EchoRaven/digital_logic/touch_board/touch_board.ip_user_files/README.txt

The files in this directory structure are automatically generated and managed by Vivado. Editing these files is not recommended.
