EchoRaven/digital_logic/touch_board/touch_board.runs/impl_1/.init_design.begin.rst

<?xml version="1.0"?>
<ProcessHandle Version="1" Minor="0">
    <Process Command=".planAhead." Owner="thb20" Host="THB" Pid="9660">
    </Process>
</ProcessHandle>
