EchoRaven/digital_logic/touch_board/touch_board.runs/blk_mem_gen_0_synth_1/.vivado.begin.rst

<?xml version="1.0"?>
<ProcessHandle Version="1" Minor="0">
    <Process Command="vivado.bat" Owner="thb20" Host="THB" Pid="5212">
    </Process>
</ProcessHandle>
