EchoRaven/digital_logic/touch_board/touch_board.runs/impl_1/usage_statistics_webtalk.html

### Device Usage Page (usage_statistics_webtalk.html)

This HTML page displays the device usage statistics that will be sent to Xilinx.
To see the actual file transmitted to Xilinx, please click here.

software_version_and_target_device
beta | FALSE | build_version | 1577090
date_generated | Fri Jan 06 22:36:52 2023 | os_platform | WIN64
product_version | Vivado v2016.2 (64-bit) | project_id | 5d2e6a21bd3f433cb3aeb27fb8cc0983
project_iteration | 230 | random_id | 56bf0cfc-a6ac-4a8f-aace-9724fa5de510
registration_id | 56bf0cfc-a6ac-4a8f-aace-9724fa5de510 | route_design | TRUE
target_device | xc7a100t | target_family | artix7
target_package | csg324 | target_speed | -1
tool_flow | Vivado

user_environment
cpu_name | 12th Gen Intel(R) Core(TM) i7-12700H | cpu_speed | 2688 MHz
os_name | Microsoft Windows 8 or later , 64-bit | os_release | major release (build 9200)
system_ram | 34.000 GB | total_processors | 1

vivado_usage

other_data

guimode=50

project_data
constraintsetcount=1 | core_container=false | currentimplrun=impl_1 | currentsynthesisrun=synth_1
default_library=xil_defaultlib | designmode=RTL | export_simulation_activehdl=5 | export_simulation_ies=5
export_simulation_modelsim=5 | export_simulation_questa=5 | export_simulation_riviera=5 | export_simulation_vcs=5
export_simulation_xsim=5 | implstrategy=Vivado Implementation Defaults | launch_simulation_activehdl=0 | launch_simulation_ies=0
launch_simulation_modelsim=0 | launch_simulation_questa=0 | launch_simulation_riviera=0 | launch_simulation_vcs=0
launch_simulation_xsim=5 | simulator_language=Mixed | srcsetcount=10 | synthesisstrategy=Vivado Synthesis Defaults
target_language=Verilog | target_simulator=XSim | totalimplruns=3 | totalsynthesisruns=3

unisim_transformation

post_unisim_transformation
bufg=4 | carry4=1099 | dsp48e1=37 | fdre=420
fdse=20 | gnd=229 | ibuf=15 | ldce=32
ldpe=3 | lut1=180 | lut2=2414 | lut3=933
lut4=410 | lut5=199 | lut6=288 | mmcme2_adv=1
muxf7=93 | muxf8=36 | obuf=25 | obuft=1
ramb18e1=2 | ramb36e1=103 | vcc=89

pre_unisim_transformation
bufg=4 | carry4=1099 | dsp48e1=37 | fdre=420
fdse=20 | gnd=229 | ibuf=16 | ldce=32
ldpe=3 | lut1=180 | lut2=2414 | lut3=933
lut4=410 | lut5=199 | lut6=288 | mmcme2_adv=1
muxf7=93 | muxf8=36 | obuf=25 | obuft=1
ramb18e1=2 | ramb36e1=103 | vcc=89

power_opt_design

command_line_options_spo
-cell_types=default::all | -clocks=default::[not_specified] | -exclude_cells=default::[not_specified] | -include_cells=default::[not_specified]

usage
bram_ports_augmented=117 | bram_ports_newly_gated=57 | bram_ports_total=210 | flow_state=default
slice_registers_augmented=0 | slice_registers_newly_gated=0 | slice_registers_total=440 | srls_augmented=0
srls_newly_gated=0 | srls_total=0

ip_statistics

blk_mem_gen_v8_3_3/1
c_addra_width=19 | c_addrb_width=19 | c_algorithm=1 | c_axi_id_width=4
c_axi_slave_type=0 | c_axi_type=1 | c_byte_size=9 | c_common_clk=0
c_count_18k_bram=1 | c_count_36k_bram=103 | c_ctrl_ecc_algo=NONE | c_default_data=0
c_disable_warn_bhv_coll=0 | c_disable_warn_bhv_range=0 | c_elaboration_dir=./ | c_en_deepsleep_pin=0
c_en_ecc_pipe=0 | c_en_rdaddra_chg=0 | c_en_rdaddrb_chg=0 | c_en_safety_ckt=0
c_en_shutdown_pin=0 | c_en_sleep_pin=0 | c_enable_32bit_address=0 | c_est_power_summary=Estimated Power for IP _ 16.887376 mW
c_family=artix7 | c_has_axi_id=0 | c_has_ena=1 | c_has_enb=1
c_has_injecterr=0 | c_has_mem_output_regs_a=0 | c_has_mem_output_regs_b=1 | c_has_mux_output_regs_a=0
c_has_mux_output_regs_b=0 | c_has_regcea=0 | c_has_regceb=0 | c_has_rsta=0
c_has_rstb=0 | c_has_softecc_input_regs_a=0 | c_has_softecc_output_regs_b=0 | c_init_file=blk_mem_gen_0.mem
c_init_file_name=no_coe_file_loaded | c_inita_val=0 | c_initb_val=0 | c_interface_type=0
c_load_init_file=0 | c_mem_type=1 | c_mux_pipeline_stages=0 | c_prim_type=1
c_read_depth_a=307200 | c_read_depth_b=307200 | c_read_width_a=12 | c_read_width_b=12
c_rst_priority_a=CE | c_rst_priority_b=CE | c_rstram_a=0 | c_rstram_b=0
c_sim_collision_check=ALL | c_use_bram_block=0 | c_use_byte_wea=0 | c_use_byte_web=0
c_use_default_data=0 | c_use_ecc=0 | c_use_softecc=0 | c_use_uram=0
c_wea_width=1 | c_web_width=1 | c_write_depth_a=307200 | c_write_depth_b=307200
c_write_mode_a=NO_CHANGE | c_write_mode_b=WRITE_FIRST | c_write_width_a=12 | c_write_width_b=12
c_xdevicefamily=artix7 | core_container=false | iptotal=1 | x_ipcorerevision=3
x_iplanguage=VERILOG | x_iplibrary=ip | x_ipname=blk_mem_gen | x_ipproduct=Vivado 2016.2
x_ipsimlanguage=MIXED | x_ipvendor=xilinx.com | x_ipversion=8.3

clk_wiz_v5_3_1/1
clkin1_period=10.0 | clkin2_period=10.0 | clock_mgr_type=NA | component_name=clk_wiz_0
core_container=false | enable_axi=0 | feedback_source=FDBK_AUTO | feedback_type=SINGLE
iptotal=1 | manual_override=false | num_out_clk=2 | primitive=MMCM
use_dyn_phase_shift=false | use_dyn_reconfig=false | use_inclk_stopped=false | use_inclk_switchover=false
use_locked=false | use_max_i_jitter=false | use_min_o_jitter=false | use_phase_alignment=true
use_power_down=false | use_reset=false

report_drc

command_line_options
-append=default::[not_specified] | -checks=default::[not_specified] | -fail_on=default::[not_specified] | -force=default::[not_specified]
-format=default::[not_specified] | -messages=default::[not_specified] | -name=default::[not_specified] | -return_string=default::[not_specified]

-ruledecks=default::[not_specified]

results
cfgbvs-1=1 | dpip-1=28 | dpop-1=34 | dpop-2=35
pdrc-153=6 | plck-12=1 | rpbf-3=1

report_power

command_line_options
-advisory=default::[not_specified] | -append=default::[not_specified] | -file=[specified] | -format=default::text
-hier=default::power | -l=default::[not_specified] | -name=default::[not_specified] | -no_propagation=default::[not_specified]
-return_string=default::[not_specified] | -rpx=[specified] | -verbose=default::[not_specified] | -vid=default::[not_specified]

-xpe=default::[not_specified]

usage
airflow=250 (LFM) | ambient_temp=25.0 (C) | bi-dir_toggle=12.500000 | bidir_output_enable=1.000000
board_layers=12to15 (12 to 15 Layers) | board_selection=medium (10"x10") | bram=0.008114 | clocks=0.006259
confidence_level_clock_activity=Medium | confidence_level_design_state=High | confidence_level_device_models=High | confidence_level_internal_activity=Medium
confidence_level_io_activity=Low | confidence_level_overall=Low | customer=TBD | customer_class=TBD
devstatic=0.102595 | die=xc7a100tcsg324-1 | dsp=0.007595 | dsp_output_toggle=12.500000
dynamic=0.175271 | effective_thetaja=4.6 | enable_probability=0.990000 | family=artix7
ff_toggle=12.500000 | flow_state=routed | heatsink=medium (Medium Profile) | i/o=0.003177
input_toggle=12.500000 | junction_temp=26.3 (C) | logic=0.009104 | mgtavcc_dynamic_current=0.000000
mgtavcc_static_current=0.000000 | mgtavcc_total_current=0.000000 | mgtavcc_voltage=1.000000 | mgtavtt_dynamic_current=0.000000
mgtavtt_static_current=0.000000 | mgtavtt_total_current=0.000000 | mgtavtt_voltage=1.200000 | mmcm=0.120411
netlist_net_matched=NA | off-chip_power=0.000000 | on-chip_power=0.277866 | output_enable=1.000000
output_load=5.000000 | output_toggle=12.500000 | package=csg324 | pct_clock_constrained=3.000000
pct_inputs_defined=0 | platform=nt64 | process=typical | ram_enable=50.000000
ram_write=50.000000 | read_saif=False | set/reset_probability=0.000000 | signal_rate=False
signals=0.020612 | simulation_file=None | speedgrade=-1 | static_prob=False
temp_grade=commercial | thetajb=5.7 (C/W) | thetasa=4.6 (C/W) | toggle_rate=False
user_board_temp=25.0 (C) | user_effective_thetaja=4.6 | user_junc_temp=26.3 (C) | user_thetajb=5.7 (C/W)
user_thetasa=4.6 (C/W) | vccadc_dynamic_current=0.000000 | vccadc_static_current=0.020000 | vccadc_total_current=0.020000
vccadc_voltage=1.800000 | vccaux_dynamic_current=0.066836 | vccaux_io_dynamic_current=0.000000 | vccaux_io_static_current=0.000000
vccaux_io_total_current=0.000000 | vccaux_io_voltage=1.800000 | vccaux_static_current=0.018179 | vccaux_total_current=0.085015
vccaux_voltage=1.800000 | vccbram_dynamic_current=0.000718 | vccbram_static_current=0.002770 | vccbram_total_current=0.003488
vccbram_voltage=1.000000 | vccint_dynamic_current=0.051326 | vccint_static_current=0.017903 | vccint_total_current=0.069229
vccint_voltage=1.000000 | vcco12_dynamic_current=0.000000 | vcco12_static_current=0.000000 | vcco12_total_current=0.000000
vcco12_voltage=1.200000 | vcco135_dynamic_current=0.000000 | vcco135_static_current=0.000000 | vcco135_total_current=0.000000
vcco135_voltage=1.350000 | vcco15_dynamic_current=0.000000 | vcco15_static_current=0.000000 | vcco15_total_current=0.000000
vcco15_voltage=1.500000 | vcco18_dynamic_current=0.000000 | vcco18_static_current=0.000000 | vcco18_total_current=0.000000
vcco18_voltage=1.800000 | vcco25_dynamic_current=0.000000 | vcco25_static_current=0.000000 | vcco25_total_current=0.000000
vcco25_voltage=2.500000 | vcco33_dynamic_current=0.000885 | vcco33_static_current=0.004000 | vcco33_total_current=0.004885
vcco33_voltage=3.300000 | version=2016.2

report_utilization

clocking
bufgctrl_available=32 | bufgctrl_fixed=0 | bufgctrl_used=5 | bufgctrl_util_percentage=15.63
bufhce_available=96 | bufhce_fixed=0 | bufhce_used=0 | bufhce_util_percentage=0.00
bufio_available=24 | bufio_fixed=0 | bufio_used=0 | bufio_util_percentage=0.00
bufmrce_available=12 | bufmrce_fixed=0 | bufmrce_used=0 | bufmrce_util_percentage=0.00
bufr_available=24 | bufr_fixed=0 | bufr_used=0 | bufr_util_percentage=0.00
mmcme2_adv_available=6 | mmcme2_adv_fixed=0 | mmcme2_adv_used=1 | mmcme2_adv_util_percentage=16.67
plle2_adv_available=6 | plle2_adv_fixed=0 | plle2_adv_used=0 | plle2_adv_util_percentage=0.00

dsp
dsp48e1_only_used=37 | dsps_available=240 | dsps_fixed=0 | dsps_used=37

dsps_util_percentage=15.42

io_standard
blvds_25=0 | diff_hstl_i=0 | diff_hstl_i_18=0 | diff_hstl_ii=0
diff_hstl_ii_18=0 | diff_hsul_12=0 | diff_mobile_ddr=0 | diff_sstl135=0
diff_sstl135_r=0 | diff_sstl15=0 | diff_sstl15_r=0 | diff_sstl18_i=0
diff_sstl18_ii=0 | hstl_i=0 | hstl_i_18=0 | hstl_ii=0
hstl_ii_18=0 | hsul_12=0 | lvcmos12=0 | lvcmos15=0
lvcmos18=0 | lvcmos25=0 | lvcmos33=1 | lvds_25=0
lvttl=0 | mini_lvds_25=0 | mobile_ddr=0 | pci33_3=0
ppds_25=0 | rsds_25=0 | sstl135=0 | sstl135_r=0
sstl15=0 | sstl15_r=0 | sstl18_i=0 | sstl18_ii=0

tmds_33=0

memory
block_ram_tile_available=135 | block_ram_tile_fixed=0 | block_ram_tile_used=104 | block_ram_tile_util_percentage=77.04
ramb18_available=270 | ramb18_fixed=0 | ramb18_used=2 | ramb18_util_percentage=0.74
ramb18e1_only_used=2 | ramb36_fifo_available=135 | ramb36_fifo_fixed=0 | ramb36_fifo_used=103
ramb36_fifo_util_percentage=76.30 | ramb36e1_only_used=103

primitives
bufg_functional_category=Clock | bufg_used=5 | carry4_functional_category=CarryLogic | carry4_used=1099
dsp48e1_functional_category=Block Arithmetic | dsp48e1_used=37 | fdce_functional_category=Flop & Latch | fdce_used=7
fdre_functional_category=Flop & Latch | fdre_used=420 | fdse_functional_category=Flop & Latch | fdse_used=20
ibuf_functional_category=IO | ibuf_used=15 | ldce_functional_category=Flop & Latch | ldce_used=32
ldpe_functional_category=Flop & Latch | ldpe_used=3 | lut1_functional_category=LUT | lut1_used=179
lut2_functional_category=LUT | lut2_used=2494 | lut3_functional_category=LUT | lut3_used=981
lut4_functional_category=LUT | lut4_used=415 | lut5_functional_category=LUT | lut5_used=199
lut6_functional_category=LUT | lut6_used=286 | mmcme2_adv_functional_category=Clock | mmcme2_adv_used=1
muxf7_functional_category=MuxFx | muxf7_used=93 | muxf8_functional_category=MuxFx | muxf8_used=36
obuf_functional_category=IO | obuf_used=25 | obuft_functional_category=IO | obuft_used=1
ramb18e1_functional_category=Block Memory | ramb18e1_used=2 | ramb36e1_functional_category=Block Memory | ramb36e1_used=103

slice_logic
f7_muxes_available=31700 | f7_muxes_fixed=0 | f7_muxes_used=93 | f7_muxes_util_percentage=0.29
f8_muxes_available=15850 | f8_muxes_fixed=0 | f8_muxes_used=36 | f8_muxes_util_percentage=0.23
lut_as_logic_available=63400 | lut_as_logic_fixed=0 | lut_as_logic_used=4387 | lut_as_logic_util_percentage=6.92
lut_as_memory_available=19000 | lut_as_memory_fixed=0 | lut_as_memory_used=0 | lut_as_memory_util_percentage=0.00
register_as_flip_flop_available=126800 | register_as_flip_flop_fixed=0 | register_as_flip_flop_used=447 | register_as_flip_flop_util_percentage=0.35
register_as_latch_available=126800 | register_as_latch_fixed=0 | register_as_latch_used=35 | register_as_latch_util_percentage=0.03
slice_luts_available=63400 | slice_luts_fixed=0 | slice_luts_used=4387 | slice_luts_util_percentage=6.92
slice_registers_available=126800 | slice_registers_fixed=0 | slice_registers_used=482 | slice_registers_util_percentage=0.38
fully_used_lut_ff_pairs_fixed=0.38 | fully_used_lut_ff_pairs_used=25 | lut_as_distributed_ram_fixed=0 | lut_as_distributed_ram_used=0
lut_as_logic_available=63400 | lut_as_logic_fixed=0 | lut_as_logic_used=4387 | lut_as_logic_util_percentage=6.92
lut_as_memory_available=19000 | lut_as_memory_fixed=0 | lut_as_memory_used=0 | lut_as_memory_util_percentage=0.00
lut_as_shift_register_fixed=0 | lut_as_shift_register_used=0 | lut_ff_pairs_with_one_unused_flip_flop_fixed=0 | lut_ff_pairs_with_one_unused_flip_flop_used=226
lut_ff_pairs_with_one_unused_lut_fixed=226 | lut_ff_pairs_with_one_unused_lut_used=215 | lut_flip_flop_pairs_available=63400 | lut_flip_flop_pairs_fixed=0
lut_flip_flop_pairs_used=255 | lut_flip_flop_pairs_util_percentage=0.40 | slice_available=15850 | slice_fixed=0
slice_used=1507 | slice_util_percentage=9.51 | slicel_fixed=0 | slicel_used=1042
slicem_fixed=0 | slicem_used=465 | unique_control_sets_used=33 | using_o5_and_o6_fixed=33
using_o5_and_o6_used=167 | using_o5_output_only_fixed=167 | using_o5_output_only_used=0 | using_o6_output_only_fixed=0

using_o6_output_only_used=4220

specific_feature
bscane2_available=4 | bscane2_fixed=0 | bscane2_used=0 | bscane2_util_percentage=0.00
capturee2_available=1 | capturee2_fixed=0 | capturee2_used=0 | capturee2_util_percentage=0.00
dna_port_available=1 | dna_port_fixed=0 | dna_port_used=0 | dna_port_util_percentage=0.00
efuse_usr_available=1 | efuse_usr_fixed=0 | efuse_usr_used=0 | efuse_usr_util_percentage=0.00
frame_ecce2_available=1 | frame_ecce2_fixed=0 | frame_ecce2_used=0 | frame_ecce2_util_percentage=0.00
icape2_available=2 | icape2_fixed=0 | icape2_used=0 | icape2_util_percentage=0.00
pcie_2_1_available=1 | pcie_2_1_fixed=0 | pcie_2_1_used=0 | pcie_2_1_util_percentage=0.00
startupe2_available=1 | startupe2_fixed=0 | startupe2_used=0 | startupe2_util_percentage=0.00
xadc_available=1 | xadc_fixed=0 | xadc_used=0 | xadc_util_percentage=0.00

router

usage
actual_expansions=13554553 | bogomips=0 | bram18=2 | bram36=103
bufg=0 | bufr=0 | congestion_level=0 | ctrls=33
dsp=37 | effort=2 | estimated_expansions=11479386 | ff=482
global_clocks=5 | high_fanout_nets=3 | iob=41 | lut=4423
movable_instances=6871 | nets=12108 | pins=78953 | pll=0
router_runtime=25.161000 | router_timing_driven=1 | threads=2 | timing_constraints_exist=1

synthesis

command_line_options
-assert=default::[not_specified] | -bufg=default::12 | -cascade_dsp=default::auto | -constrset=default::[not_specified]
-control_set_opt_threshold=default::auto | -directive=default::default | -fanout_limit=default::10000 | -flatten_hierarchy=default::rebuilt
-fsm_extraction=default::auto | -gated_clock_conversion=default::off | -generic=default::[not_specified] | -include_dirs=default::[not_specified]
-keep_equivalent_registers=default::[not_specified] | -max_bram=default::-1 | -max_bram_cascade_height=default::-1 | -max_dsp=default::-1
-max_uram=default::-1 | -max_uram_cascade_height=default::-1 | -mode=default::default | -name=default::[not_specified]
-no_lc=default::[not_specified] | -no_srlextract=default::[not_specified] | -no_timing_driven=default::[not_specified] | -part=xc7a100tcsg324-1
-resource_sharing=default::auto | -retiming=default::[not_specified] | -rtl=default::[not_specified] | -rtl_skip_constraints=default::[not_specified]
-rtl_skip_ip=default::[not_specified] | -seu_protect=default::none | -shreg_min_size=default::3 | -top=LinearFitting

-verilog_define=default::[not_specified]

usage
elapsed=00:00:26s | hls_ip=0 | memory_gain=513.125MB | memory_peak=744.277MB

xsim

command_line_options
-sim_mode=default::behavioral | -sim_type=default::
