EchoRaven/digital_logic/touch_board/touch_board.sim/sim_1/behav/xsim.dir/touch_board_behav/webtalk/usage_statistics_ext_xsim.html

### XSIM Usage Report

software_version_and_target_device
beta | FALSE | build_version | 1577090
date_generated | Tue Jan 03 23:48:22 2023 | os_platform | WIN64
product_version | XSIM v2016.2 (64-bit) | project_id | 5d2e6a21bd3f433cb3aeb27fb8cc0983
project_iteration | 2 | random_id | 56bf0cfc-a6ac-4a8f-aace-9724fa5de510
registration_id | 56bf0cfc-a6ac-4a8f-aace-9724fa5de510 | route_design | FALSE
target_device | not_applicable | target_family | not_applicable
target_package | not_applicable | target_speed | not_applicable
tool_flow | xsim_vivado

user_environment
cpu_name | 12th Gen Intel(R) Core(TM) i7-12700H | cpu_speed | 2688 MHz
os_name | Microsoft Windows 8 or later , 64-bit | os_release | major release (build 9200)
system_ram | 34.000 GB | total_processors | 1

vivado_usage

xsim

command_line_options

command=xsim

usage
iteration=0 | runtime=1 us | simulation_memory=13200_KB | simulation_time=0.12_sec

trace_waveform=true
