EchoRaven/digital_logic/touch_board/touch_board.runs/synth_1/.Xil/LinearFitting_propImpl.xdc

set_property SRC_FILE_INFO {cfile:C:/Users/thb20/Desktop/Big_homework/touch_board/touch_board.srcs/constrs_1/new/top.xdc rfile:../../../touch_board.srcs/constrs_1/new/top.xdc id:1} [current_design]
set_property src_info {type:XDC file:1 line:1 export:INPUT save:INPUT read:READ} [current_design]
set_property PACKAGE_PIN J15 [get_ports rst]
set_property src_info {type:XDC file:1 line:4 export:INPUT save:INPUT read:READ} [current_design]
set_property PACKAGE_PIN E3 [get_ports clk]
set_property src_info {type:XDC file:1 line:7 export:INPUT save:INPUT read:READ} [current_design]
set_property PACKAGE_PIN B12 [get_ports y_valid]
set_property src_info {type:XDC file:1 line:10 export:INPUT save:INPUT read:READ} [current_design]
set_property PACKAGE_PIN B11 [get_ports x_valid]
set_property src_info {type:XDC file:1 line:13 export:INPUT save:INPUT read:READ} [current_design]
set_property PACKAGE_PIN A3 [get_ports {red_out[0]}]
set_property src_info {type:XDC file:1 line:15 export:INPUT save:INPUT read:READ} [current_design]
set_property PACKAGE_PIN B4 [get_ports {red_out[1]}]
set_property src_info {type:XDC file:1 line:17 export:INPUT save:INPUT read:READ} [current_design]
set_property PACKAGE_PIN C5 [get_ports {red_out[2]}]
set_property src_info {type:XDC file:1 line:19 export:INPUT save:INPUT read:READ} [current_design]
set_property PACKAGE_PIN A4 [get_ports {red_out[3]}]
set_property src_info {type:XDC file:1 line:22 export:INPUT save:INPUT read:READ} [current_design]
set_property PACKAGE_PIN C6 [get_ports {green_out[0]}]
set_property src_info {type:XDC file:1 line:24 export:INPUT save:INPUT read:READ} [current_design]
set_property PACKAGE_PIN A5 [get_ports {green_out[1]}]
set_property src_info {type:XDC file:1 line:26 export:INPUT save:INPUT read:READ} [current_design]
set_property PACKAGE_PIN B6 [get_ports {green_out[2]}]
set_property src_info {type:XDC file:1 line:28 export:INPUT save:INPUT read:READ} [current_design]
set_property PACKAGE_PIN A6 [get_ports {green_out[3]}]
set_property src_info {type:XDC file:1 line:31 export:INPUT save:INPUT read:READ} [current_design]
set_property PACKAGE_PIN B7 [get_ports {blue_out[0]}]
set_property src_info {type:XDC file:1 line:33 export:INPUT save:INPUT read:READ} [current_design]
set_property PACKAGE_PIN C7 [get_ports {blue_out[1]}]
set_property src_info {type:XDC file:1 line:35 export:INPUT save:INPUT read:READ} [current_design]
set_property PACKAGE_PIN D7 [get_ports {blue_out[2]}]
set_property src_info {type:XDC file:1 line:37 export:INPUT save:INPUT read:READ} [current_design]
set_property PACKAGE_PIN D8 [get_ports {blue_out[3]}]
set_property src_info {type:XDC file:1 line:40 export:INPUT save:INPUT read:READ} [current_design]
set_property PACKAGE_PIN C17 [get_ports pwdn]
set_property src_info {type:XDC file:1 line:43 export:INPUT save:INPUT read:READ} [current_design]
set_property PACKAGE_PIN D18 [get_ports {camera_data[0]}]
set_property src_info {type:XDC file:1 line:46 export:INPUT save:INPUT read:READ} [current_design]
set_property PACKAGE_PIN E18 [get_ports {camera_data[2]}]
set_property src_info {type:XDC file:1 line:49 export:INPUT save:INPUT read:READ} [current_design]
set_property PACKAGE_PIN G17 [get_ports {camera_data[4]}]
set_property src_info {type:XDC file:1 line:52 export:INPUT save:INPUT read:READ} [current_design]
set_property PACKAGE_PIN D17 [get_ports reset]
set_property src_info {type:XDC file:1 line:55 export:INPUT save:INPUT read:READ} [current_design]
set_property PACKAGE_PIN E17 [get_ports {camera_data[1]}]
set_property src_info {type:XDC file:1 line:58 export:INPUT save:INPUT read:READ} [current_design]
set_property PACKAGE_PIN F18 [get_ports {camera_data[3]}]
set_property src_info {type:XDC file:1 line:61 export:INPUT save:INPUT read:READ} [current_design]
set_property PACKAGE_PIN G18 [get_ports {camera_data[5]}]
set_property src_info {type:XDC file:1 line:64 export:INPUT save:INPUT read:READ} [current_design]
set_property PACKAGE_PIN D14 [get_ports {camera_data[6]}]
set_property src_info {type:XDC file:1 line:67 export:INPUT save:INPUT read:READ} [current_design]
set_property PACKAGE_PIN F16 [get_ports xclk]
set_property src_info {type:XDC file:1 line:70 export:INPUT save:INPUT read:READ} [current_design]
set_property PACKAGE_PIN G16 [get_ports href]
set_property src_info {type:XDC file:1 line:73 export:INPUT save:INPUT read:READ} [current_design]
set_property PACKAGE_PIN H14 [get_ports sio_d]
set_property src_info {type:XDC file:1 line:78 export:INPUT save:INPUT read:READ} [current_design]
set_property PACKAGE_PIN E16 [get_ports {camera_data[7]}]
set_property src_info {type:XDC file:1 line:81 export:INPUT save:INPUT read:READ} [current_design]
set_property PACKAGE_PIN F13 [get_ports pclk]
set_property src_info {type:XDC file:1 line:84 export:INPUT save:INPUT read:READ} [current_design]
set_property PACKAGE_PIN G13 [get_ports vsync]
set_property src_info {type:XDC file:1 line:87 export:INPUT save:INPUT read:READ} [current_design]
set_property PACKAGE_PIN H16 [get_ports sio_c]
set_property src_info {type:XDC file:1 line:94 export:INPUT save:INPUT read:READ} [current_design]
set_property PACKAGE_PIN L16 [get_ports clr]
set_property src_info {type:XDC file:1 line:97 export:INPUT save:INPUT read:READ} [current_design]
set_property IOSTANDARD LVCMOS33 [get_ports tag1]
set_property src_info {type:XDC file:1 line:98 export:INPUT save:INPUT read:READ} [current_design]
set_property PACKAGE_PIN H17 [get_ports tag1]
set_property src_info {type:XDC file:1 line:99 export:INPUT save:INPUT read:READ} [current_design]
set_property IOSTANDARD LVCMOS33 [get_ports tag2]
set_property src_info {type:XDC file:1 line:100 export:INPUT save:INPUT read:READ} [current_design]
set_property PACKAGE_PIN K15 [get_ports tag2]
set_property src_info {type:XDC file:1 line:101 export:INPUT save:INPUT read:READ} [current_design]
set_property IOSTANDARD LVCMOS33 [get_ports tag3]
set_property src_info {type:XDC file:1 line:102 export:INPUT save:INPUT read:READ} [current_design]
set_property PACKAGE_PIN J13 [get_ports tag3]
set_property src_info {type:XDC file:1 line:103 export:INPUT save:INPUT read:READ} [current_design]
set_property IOSTANDARD LVCMOS33 [get_ports tag4]
set_property src_info {type:XDC file:1 line:104 export:INPUT save:INPUT read:READ} [current_design]
set_property PACKAGE_PIN N14 [get_ports tag4]
set_property src_info {type:XDC file:1 line:113 export:INPUT save:INPUT read:READ} [current_design]
set_property PACKAGE_PIN L18 [get_ports {display[6]}]
set_property src_info {type:XDC file:1 line:114 export:INPUT save:INPUT read:READ} [current_design]
set_property PACKAGE_PIN T11 [get_ports {display[5]}]
set_property src_info {type:XDC file:1 line:115 export:INPUT save:INPUT read:READ} [current_design]
set_property PACKAGE_PIN P15 [get_ports {display[4]}]
set_property src_info {type:XDC file:1 line:116 export:INPUT save:INPUT read:READ} [current_design]
set_property PACKAGE_PIN K13 [get_ports {display[3]}]
set_property src_info {type:XDC file:1 line:117 export:INPUT save:INPUT read:READ} [current_design]
set_property PACKAGE_PIN K16 [get_ports {display[2]}]
set_property src_info {type:XDC file:1 line:118 export:INPUT save:INPUT read:READ} [current_design]
set_property PACKAGE_PIN R10 [get_ports {display[1]}]
set_property src_info {type:XDC file:1 line:119 export:INPUT save:INPUT read:READ} [current_design]
set_property PACKAGE_PIN T10 [get_ports {display[0]}]
set_property src_info {type:XDC file:1 line:120 export:INPUT save:INPUT read:READ} [current_design]
set_property PACKAGE_PIN G6 [get_ports pmod]
set_property src_info {type:XDC file:1 line:123 export:INPUT save:INPUT read:READ} [current_design]
set_property PACKAGE_PIN M13 [get_ports color]
set_property src_info {type:XDC file:1 line:124 export:INPUT save:INPUT read:READ} [current_design]
set_property IOSTANDARD LVCMOS33 [get_ports color]
