EchoRaven/digital_logic/touch_board/touch_board.ip_user_files/ip/blk_mem_gen_0/blk_mem_gen_0_stub.v

// Copyright 1986-2016 Xilinx, Inc. All Rights Reserved.
// --------------------------------------------------------------------------------
// Tool Version: Vivado v.2016.2 (win64) Build 1577090 Thu Jun  2 16:32:40 MDT 2016
// Date        : Thu Dec 29 22:28:01 2022
// Host        : thb running 64-bit major release  (build 9200)
// Command     : write_verilog -force -mode synth_stub
//               c:/Users/thb20/Desktop/Big_homework/touch_board/touch_board.srcs/sources_1/ip/blk_mem_gen_0/blk_mem_gen_0_stub.v
// Design      : blk_mem_gen_0
// Purpose     : Stub declaration of top-level module interface
// Device      : xc7a100tcsg324-1
// --------------------------------------------------------------------------------

// This empty module with port declaration file causes synthesis tools to infer a black box for IP.
// The synthesis directives are for Synopsys Synplify support to prevent IO buffer insertion.
// Please paste the declaration into a Verilog source file or add the file as an additional source.
(* x_core_info = "blk_mem_gen_v8_3_3,Vivado 2016.2" *)
module blk_mem_gen_0(clka, ena, wea, addra, dina, clkb, enb, addrb, doutb)
/* synthesis syn_black_box black_box_pad_pin="clka,ena,wea[0:0],addra[18:0],dina[11:0],clkb,enb,addrb[18:0],doutb[11:0]" */;
  input clka;
  input ena;
  input [0:0]wea;
  input [18:0]addra;
  input [11:0]dina;
  input clkb;
  input enb;
  input [18:0]addrb;
  output [11:0]doutb;
endmodule
