EchoRaven/digital_logic/touch_board/touch_board.ip_user_files/ip/blk_mem_gen_0/blk_mem_gen_0_stub.vhdl

-- Copyright 1986-2016 Xilinx, Inc. All Rights Reserved.
-- --------------------------------------------------------------------------------
-- Tool Version: Vivado v.2016.2 (win64) Build 1577090 Thu Jun  2 16:32:40 MDT 2016
-- Date        : Thu Dec 29 22:28:01 2022
-- Host        : thb running 64-bit major release  (build 9200)
-- Command     : write_vhdl -force -mode synth_stub
--               c:/Users/thb20/Desktop/Big_homework/touch_board/touch_board.srcs/sources_1/ip/blk_mem_gen_0/blk_mem_gen_0_stub.vhdl
-- Design      : blk_mem_gen_0
-- Purpose     : Stub declaration of top-level module interface
-- Device      : xc7a100tcsg324-1
-- --------------------------------------------------------------------------------
library IEEE;
use IEEE.STD_LOGIC_1164.ALL;

entity blk_mem_gen_0 is
  Port ( 
    clka : in STD_LOGIC;
    ena : in STD_LOGIC;
    wea : in STD_LOGIC_VECTOR ( 0 to 0 );
    addra : in STD_LOGIC_VECTOR ( 18 downto 0 );
    dina : in STD_LOGIC_VECTOR ( 11 downto 0 );
    clkb : in STD_LOGIC;
    enb : in STD_LOGIC;
    addrb : in STD_LOGIC_VECTOR ( 18 downto 0 );
    doutb : out STD_LOGIC_VECTOR ( 11 downto 0 )
  );

end blk_mem_gen_0;

architecture stub of blk_mem_gen_0 is
attribute syn_black_box : boolean;
attribute black_box_pad_pin : string;
attribute syn_black_box of stub : architecture is true;
attribute black_box_pad_pin of stub : architecture is "clka,ena,wea[0:0],addra[18:0],dina[11:0],clkb,enb,addrb[18:0],doutb[11:0]";
attribute x_core_info : string;
attribute x_core_info of stub : architecture is "blk_mem_gen_v8_3_3,Vivado 2016.2";
begin
end;
